StefanHoria/Industrial-Robot-Design/CATIA/imagini/Bac_V1_sus.png

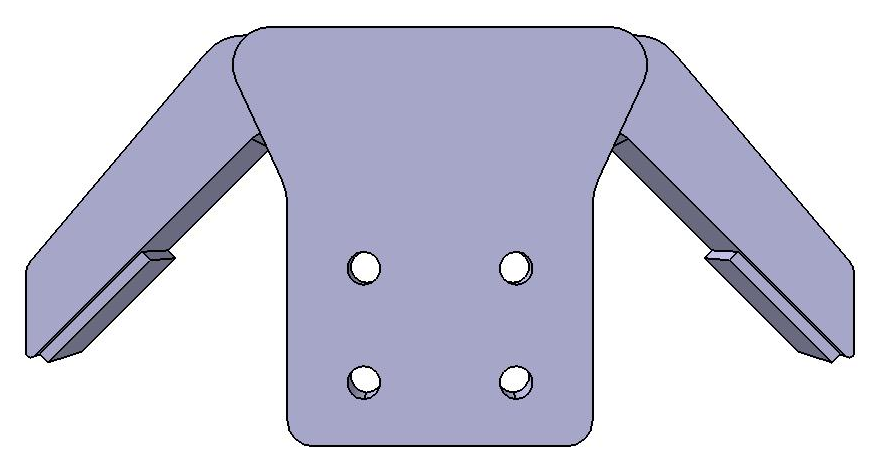
CATIA/imagini/Bac_V1_sus.png
