StefanHoria/Industrial-Robot-Design/CATIA/imagini/Bac_V_sus.png

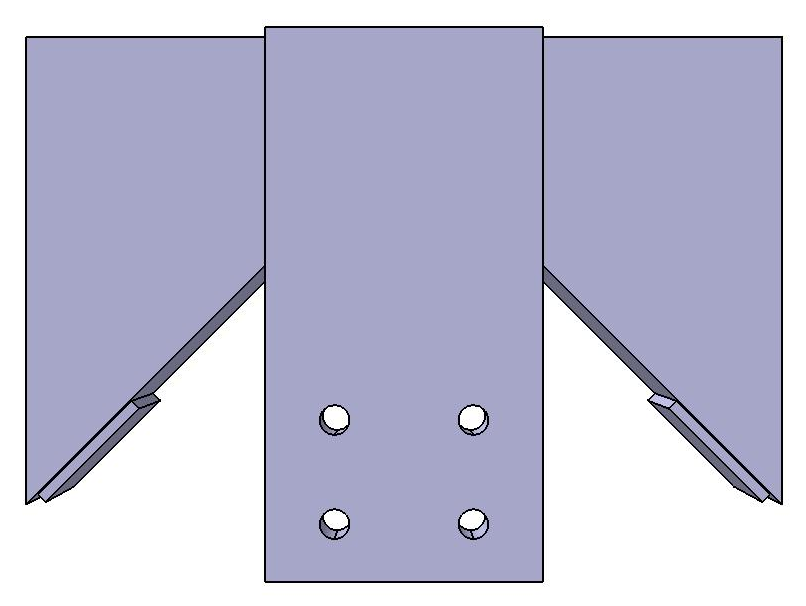
CATIA/imagini/Bac_V_sus.png
