StefanHoria/Industrial-Robot-Design/CATIA/imagini/Efector_E1_fata.png

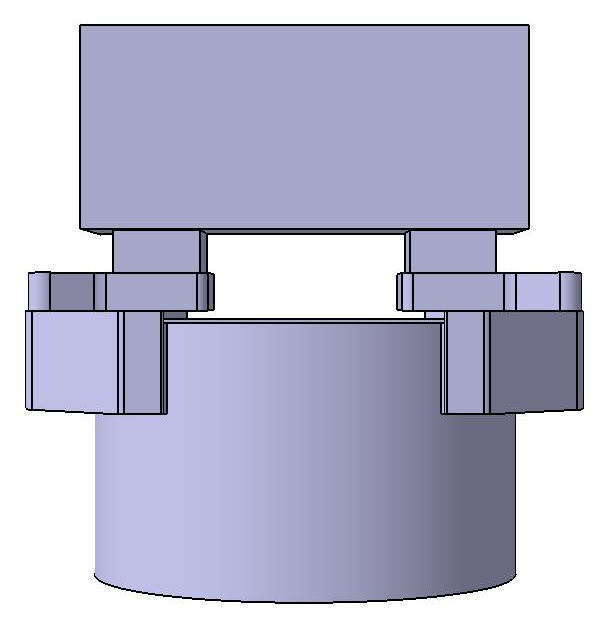
CATIA/imagini/Efector_E1_fata.png
