StefanHoria/Industrial-Robot-Design/CATIA/imagini/Efector_E_fata.png

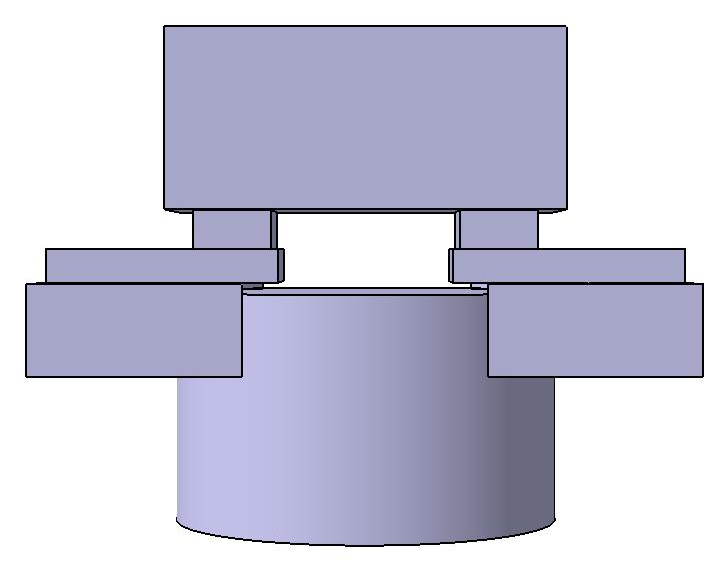
CATIA/imagini/Efector_E_fata.png
