StefanHoria/Industrial-Robot-Design/CATIA/imagini/R1_Corp_iso.png

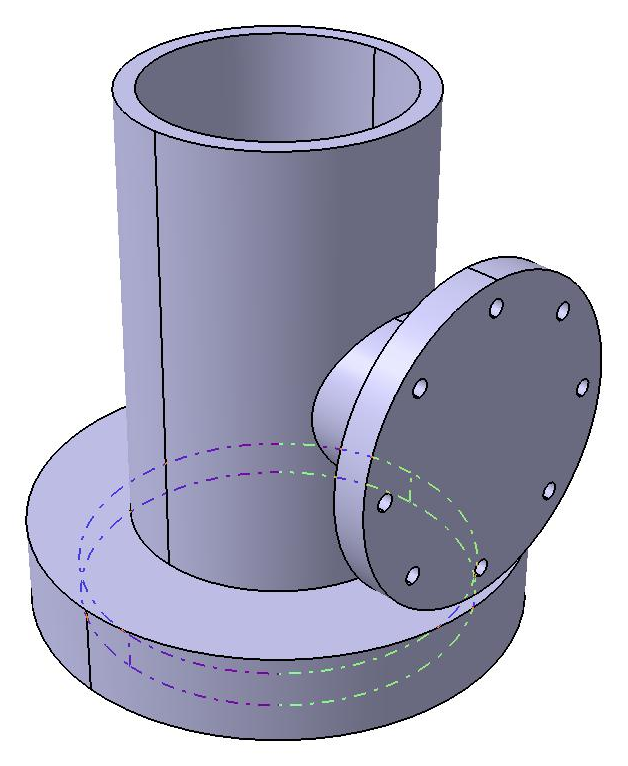
CATIA/imagini/R1_Corp_iso.png
