StefanHoria/Industrial-Robot-Design/MATLAB/ver1/imagini/model_simscape.png

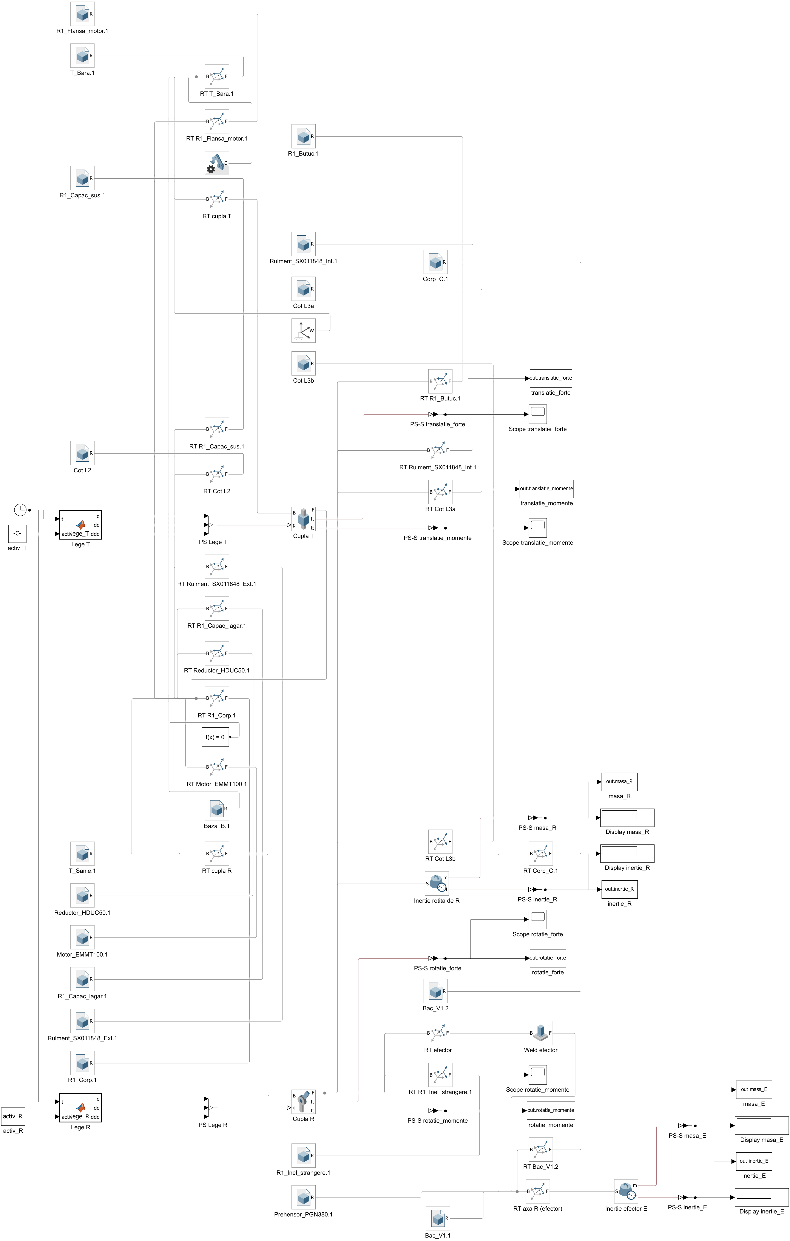
MATLAB/ver1/imagini/model_simscape.png
