StefanHoria/Industrial-Robot-Design/schema_functionla.jpg

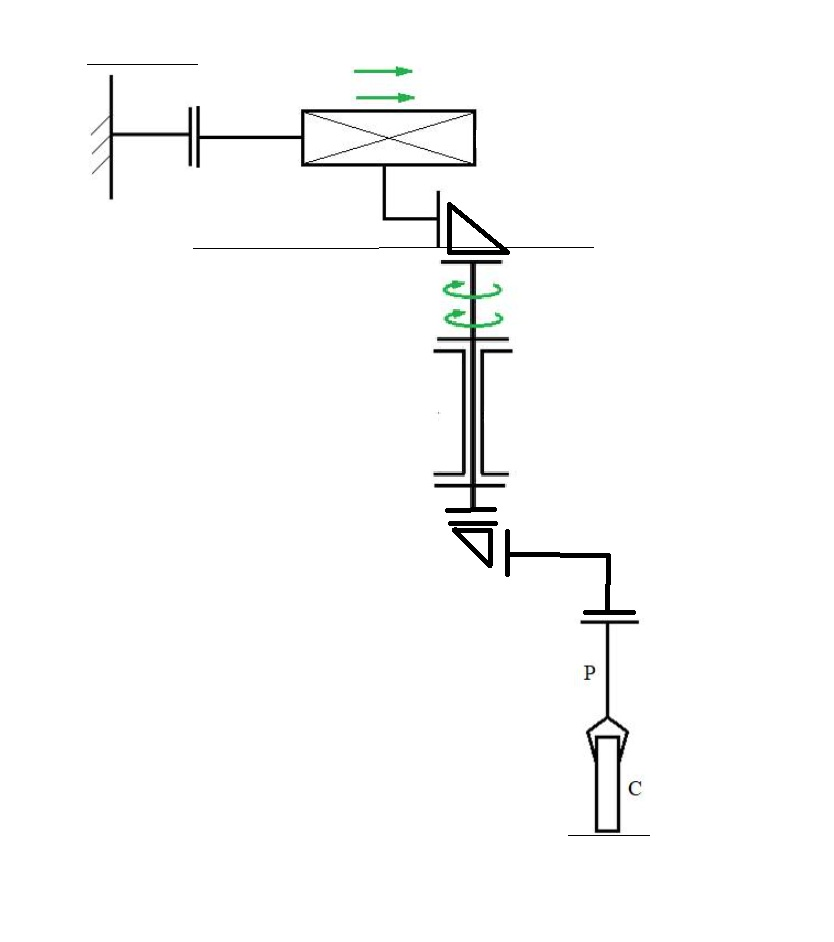
schema_functionla.jpg
