StefanHoria/Industrial-Robot-Design/CATIA/STEP/R1_Corp.stp

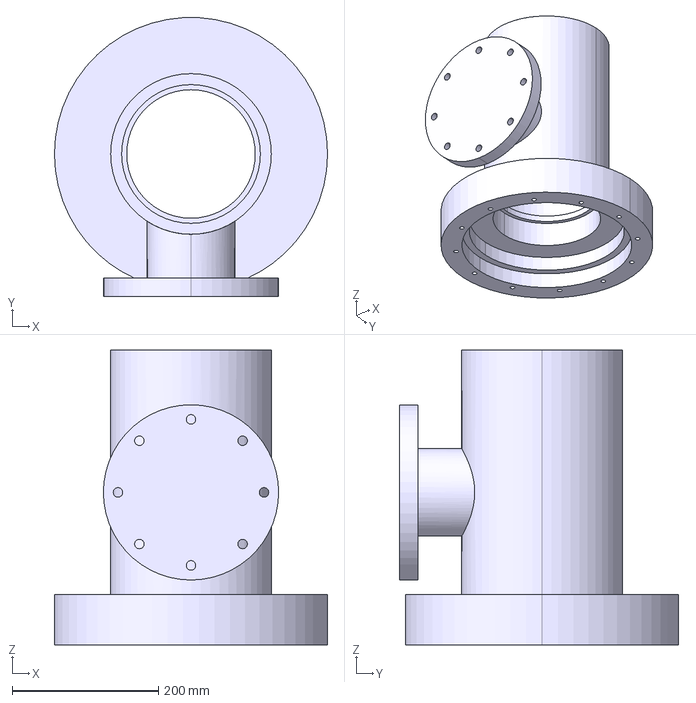
[picture p45: CAD file, 2026-11-06]
CATIA/STEP/R1_Corp.stp
374.0 x 381.7 x 404.0 mm
