StefanHoria/Industrial-Robot-Design/CATIA/STEP/R1_Flansa_motor.stp

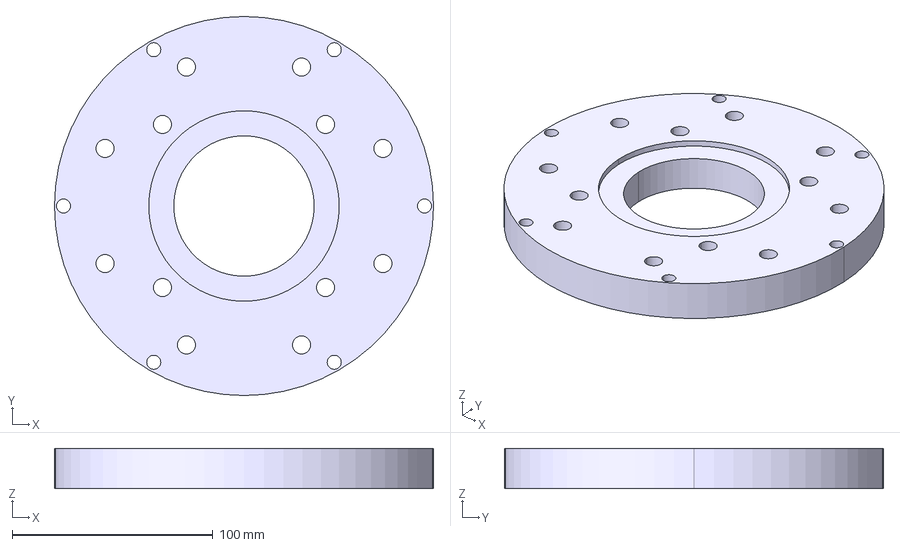
[picture p46: CAD file, 2026-11-06]
CATIA/STEP/R1_Flansa_motor.stp
189.0 x 189.0 x 20.0 mm
