StefanHoria/Industrial-Robot-Design/CATIA/STEP/Rulment_SX011848_Ext.stp

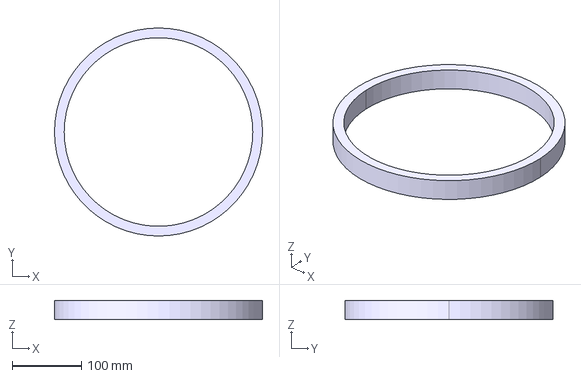
[picture p47: CAD file, 2026-11-06]
CATIA/STEP/Rulment_SX011848_Ext.stp
300.0 x 300.0 x 28.0 mm
