StefanHoria/Industrial-Robot-Design/CATIA/STEP/Modul_R1.stp

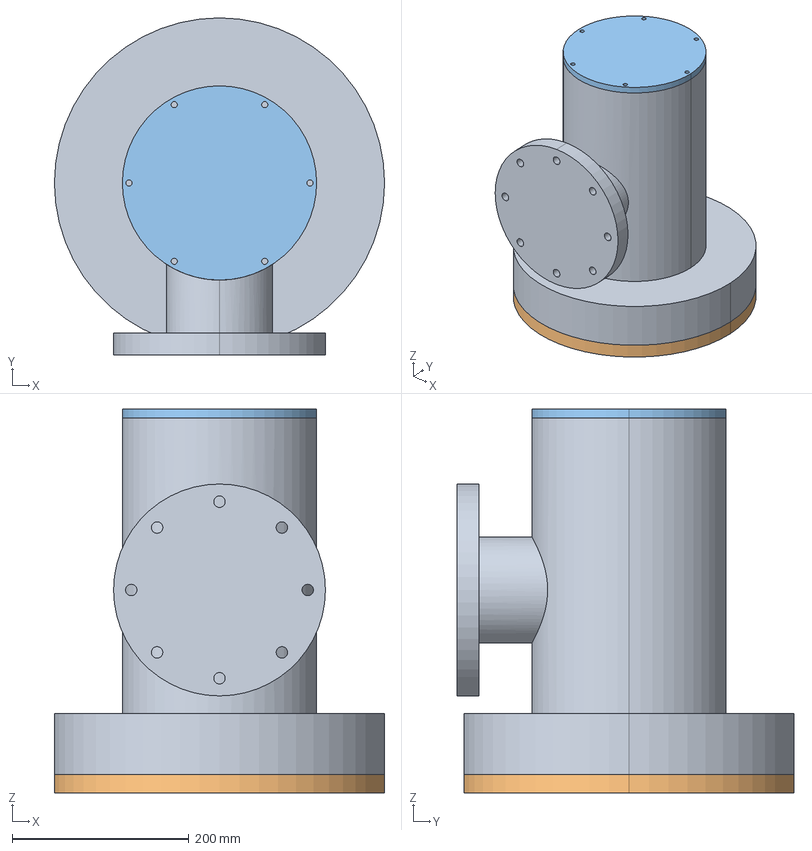
[picture p48: CAD file, 2026-11-06]
CATIA/STEP/Modul_R1.stp
374.0 x 382.0 x 435.0 mm
R1_Corp
R1_Capac_lagar
Rulment_SX011848_Ext
Rulment_SX011848_Int
R1_Butuc
R1_Inel_strangere
Reductor_HDUC50
R1_Flansa_motor
Motor_EMMT100
R1_Capac_sus
