StefanHoria/Industrial-Robot-Design/CATIA/STEP/R1_Butuc.stp

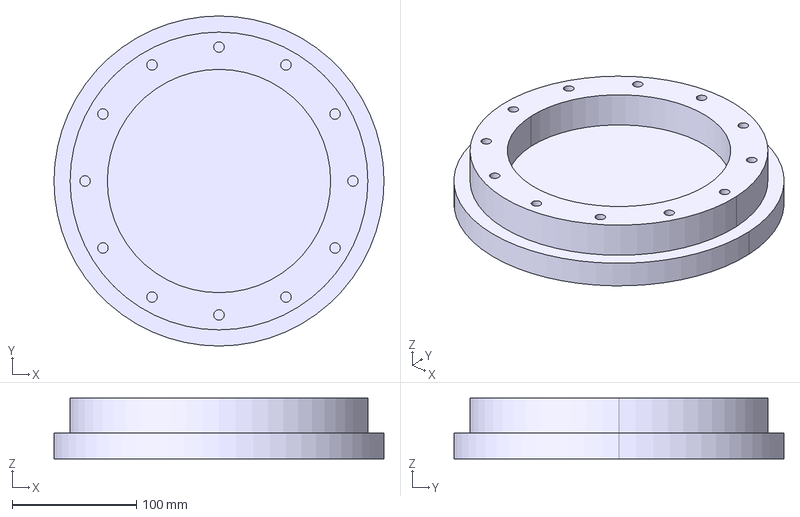
[picture p49: CAD file, 2026-11-06]
CATIA/STEP/R1_Butuc.stp
266.0 x 266.0 x 49.0 mm
