StefanHoria/Industrial-Robot-Design/CATIA/STEP/R1_Inel_strangere.stp

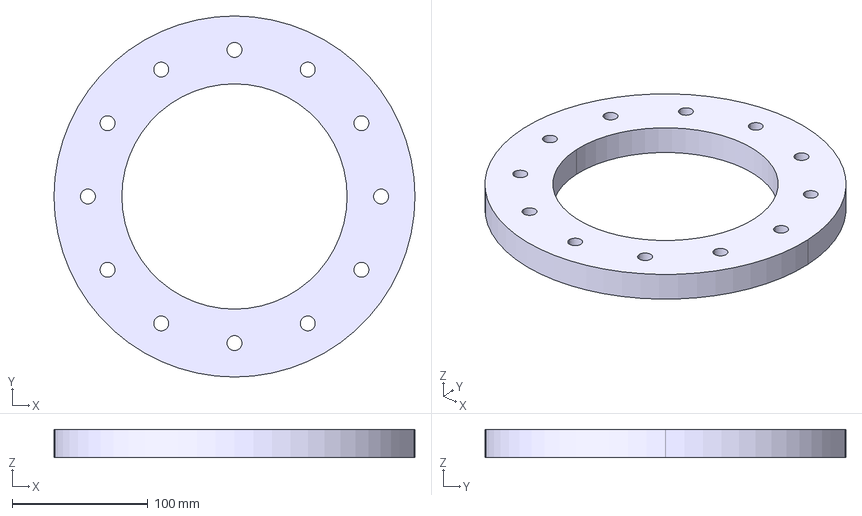
[picture p50: CAD file, 2026-11-06]
CATIA/STEP/R1_Inel_strangere.stp
266.0 x 266.0 x 21.0 mm
