StefanHoria/Industrial-Robot-Design/CATIA/STEP/Bac_V1.stp

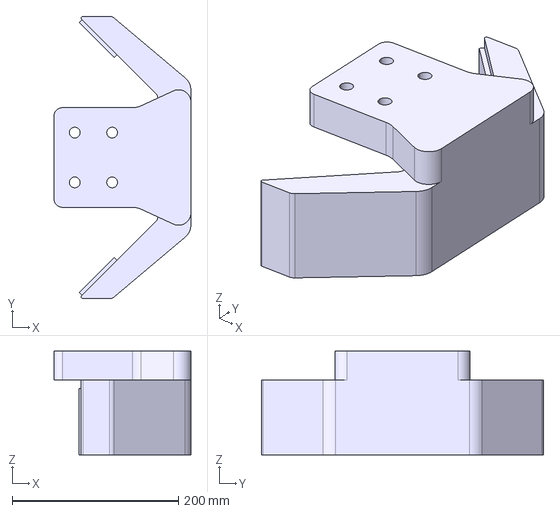
[picture p51: CAD file, 2026-11-06]
CATIA/STEP/Bac_V1.stp
165.0 x 340.0 x 125.0 mm
