StefanHoria/Industrial-Robot-Design/CATIA/STEP/Efector_E1.stp

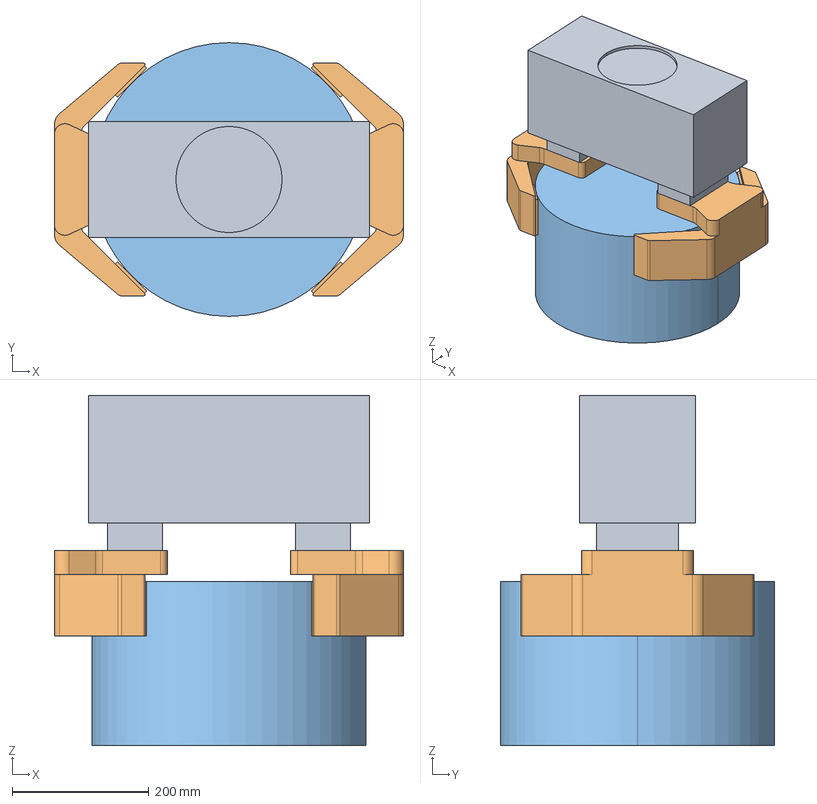
[picture p52: CAD file, 2026-11-06]
CATIA/STEP/Efector_E1.stp
510.0 x 400.0 x 511.5 mm
Prehensor_PGN380
Bac_V1 x 2
Corp_C
