StefanHoria/Industrial-Robot-Design/CATIA/STEP/Reductor_HDUC50.stp

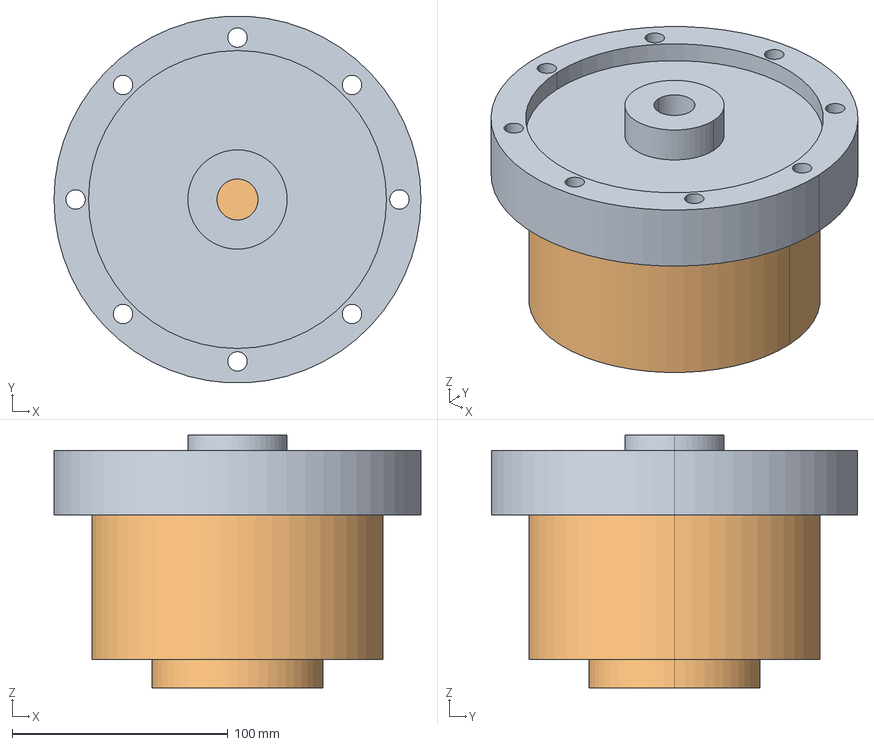
[picture p53: CAD file, 2026-11-06]
CATIA/STEP/Reductor_HDUC50.stp
170.0 x 169.8 x 117.0 mm
