StefanHoria/Industrial-Robot-Design/CATIA/STEP/Rulment_SX011848_Int.stp

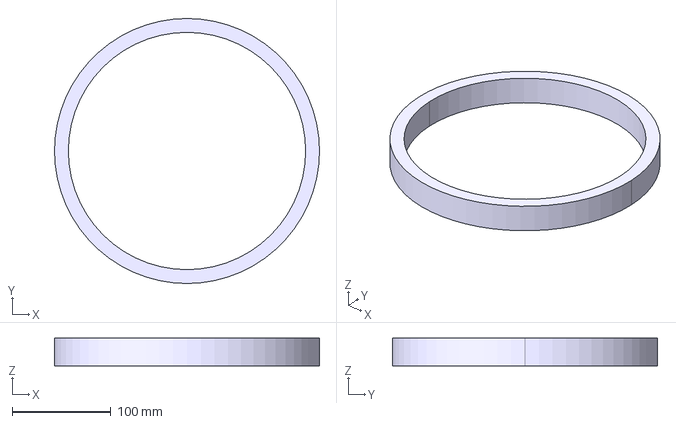
[picture p54: CAD file, 2026-11-06]
CATIA/STEP/Rulment_SX011848_Int.stp
268.0 x 268.0 x 28.0 mm
