StefanHoria/Industrial-Robot-Design/CATIA/STEP/Motor_EMMT100.stp

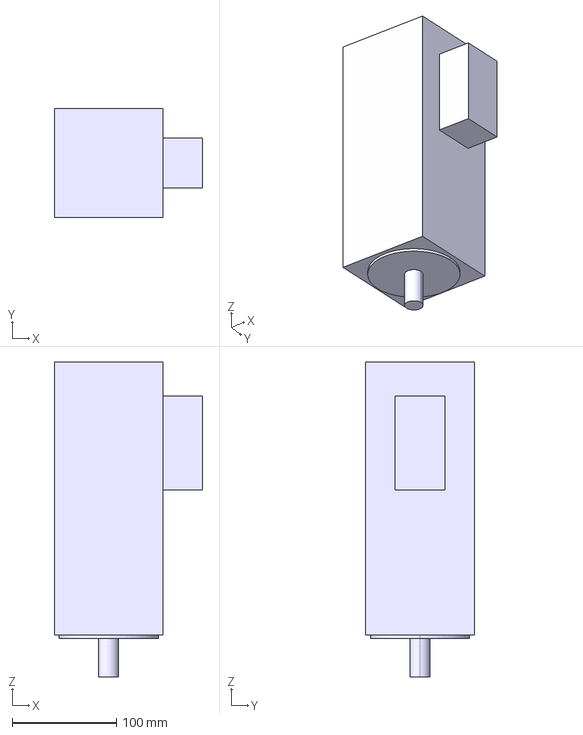
[picture p55: CAD file, 2026-11-06]
CATIA/STEP/Motor_EMMT100.stp
142.0 x 104.0 x 301.7 mm
