StefanHoria/Industrial-Robot-Design/CATIA/STEP/R1_Capac_sus.stp

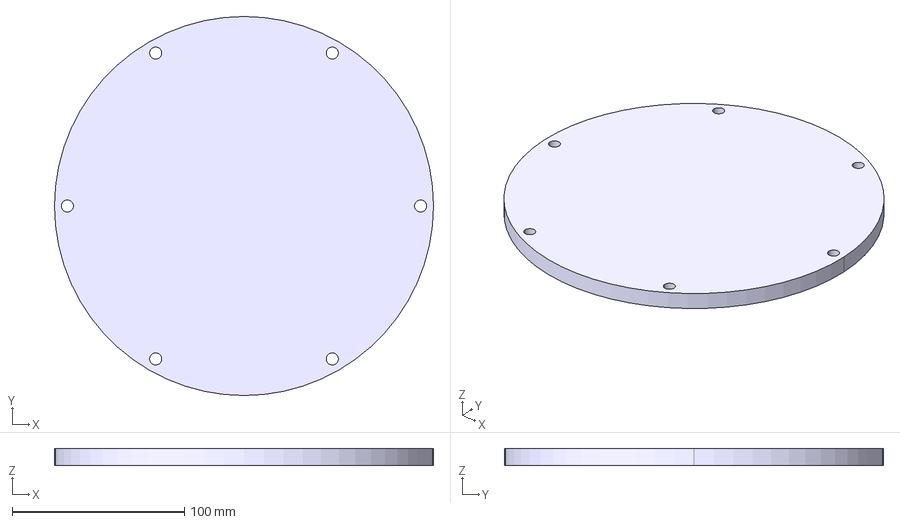
[picture p56: CAD file, 2026-11-06]
CATIA/STEP/R1_Capac_sus.stp
220.0 x 220.0 x 10.0 mm
