StefanHoria/Industrial-Robot-Design/CATIA/STEP/R1_Capac_lagar.stp

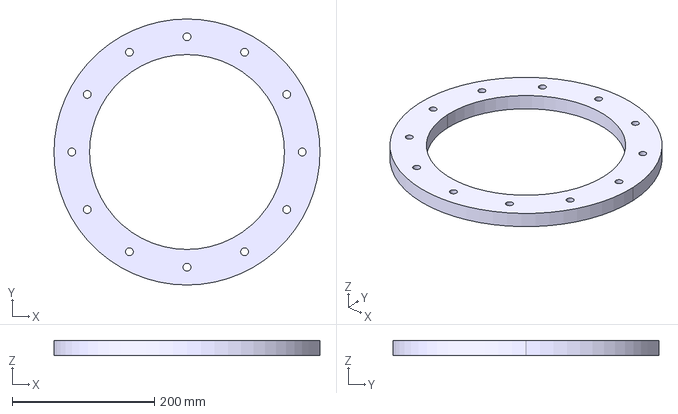
[picture p57: CAD file, 2026-11-06]
CATIA/STEP/R1_Capac_lagar.stp
374.0 x 374.0 x 21.0 mm
