StefanHoria/Industrial-Robot-Design/CATIA/STEP/Robot_v1.stp

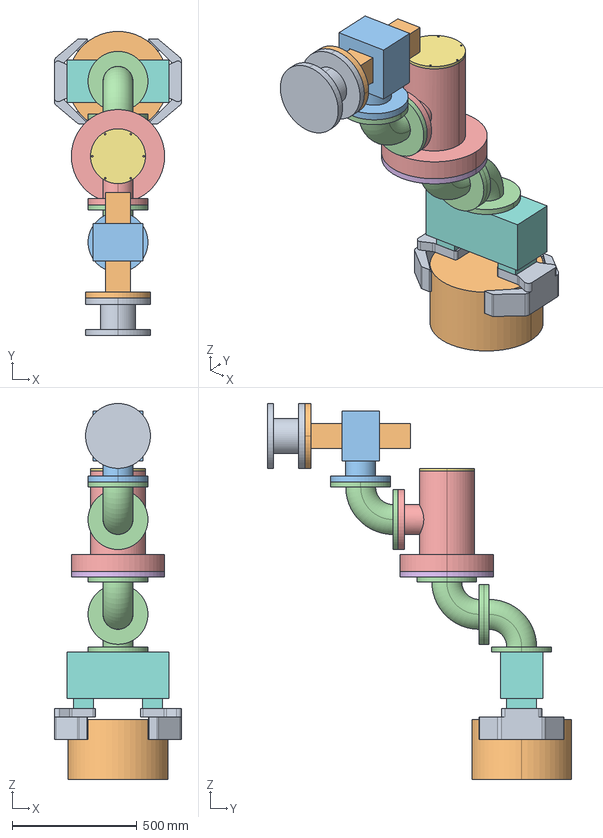
[picture p58: CAD file, 2026-11-06]
CATIA/STEP/Robot_v1.stp
510.0 x 1218.8 x 1506.5 mm
Baza_B
T_Bara
T_Sanie
Cot_90 x 3
R1_Corp
R1_Capac_lagar
Rulment_SX011848_Ext
Rulment_SX011848_Int
R1_Butuc
R1_Inel_strangere
Reductor_HDUC50
R1_Flansa_motor
Motor_EMMT100
R1_Capac_sus
Prehensor_PGN380
Bac_V1 x 2
Corp_C
