StefanHoria/Industrial-Robot-Design/CATIA/STEP/T_Sanie.stp

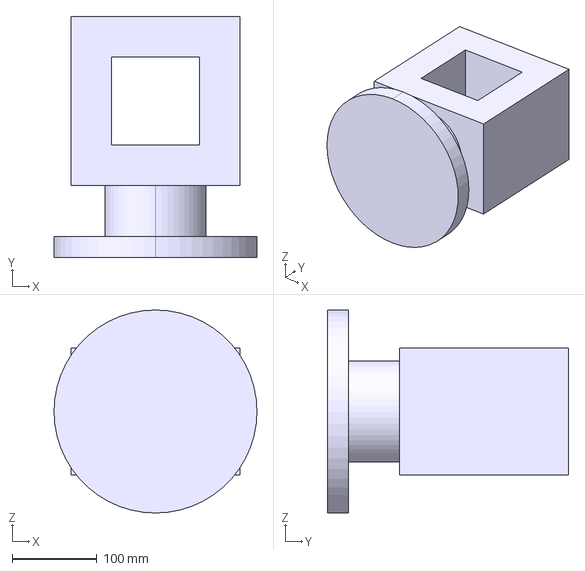
[picture p59: CAD file, 2026-11-03]
CATIA/STEP/T_Sanie.stp
240.0 x 285.0 x 240.0 mm
