StefanHoria/Industrial-Robot-Design/CATIA/STEP/Bac_V.stp

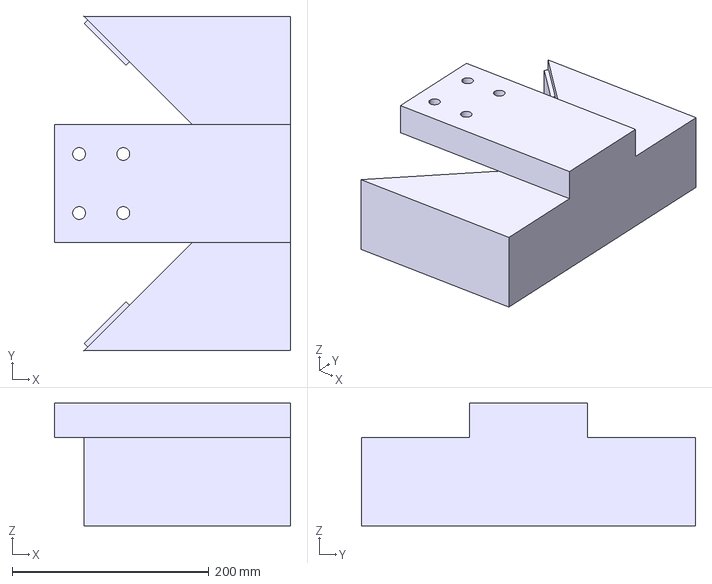
[picture p60: CAD file, 2026-11-03]
CATIA/STEP/Bac_V.stp
239.9 x 340.0 x 125.0 mm
