StefanHoria/Industrial-Robot-Design/CATIA/STEP/Modul_R.stp

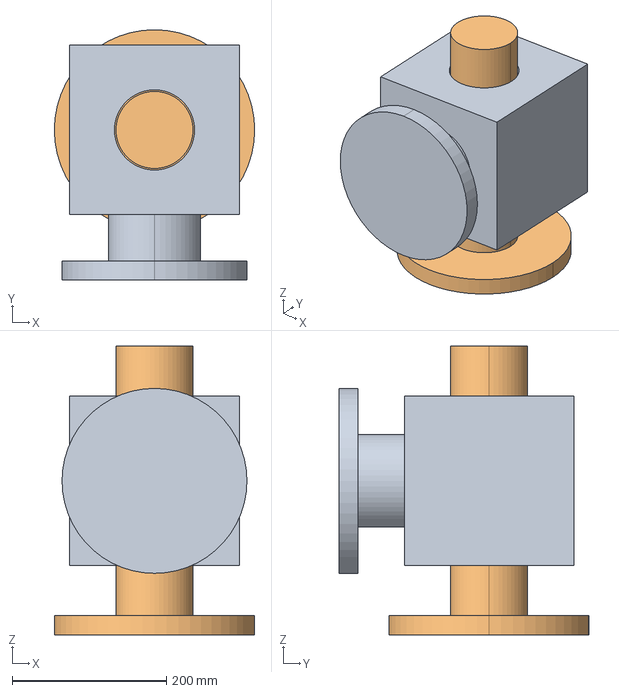
[picture p61: CAD file, 2026-11-03]
CATIA/STEP/Modul_R.stp
260.0 x 325.0 x 375.0 mm
R_Carcasa
R_Arbore
