StefanHoria/Industrial-Robot-Design/CATIA/STEP/T_Bara.stp

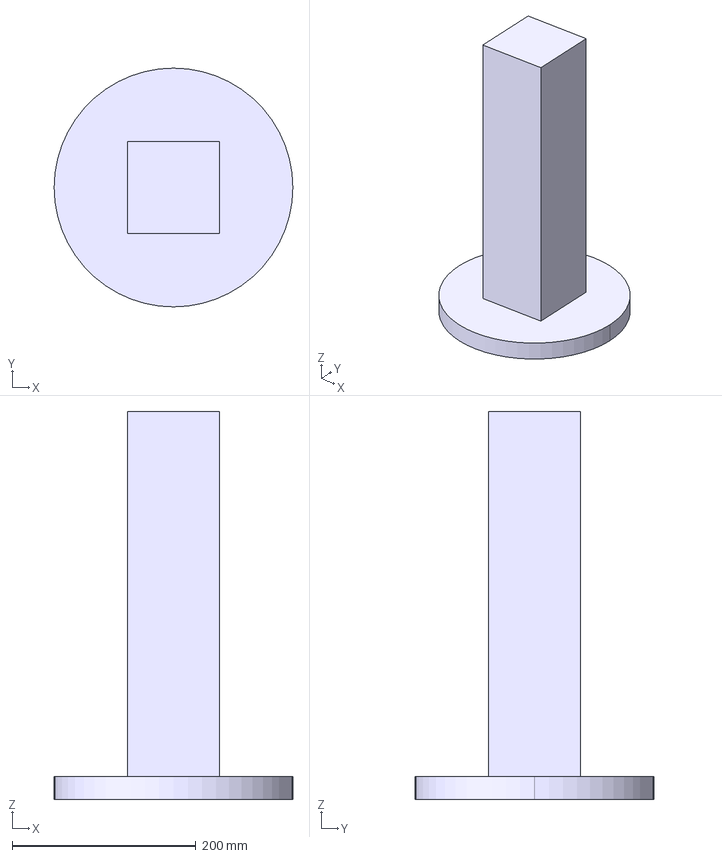
[picture p62: CAD file, 2026-11-03]
CATIA/STEP/T_Bara.stp
260.0 x 260.0 x 422.5 mm
