StefanHoria/Industrial-Robot-Design/CATIA/STEP/R_Arbore.stp

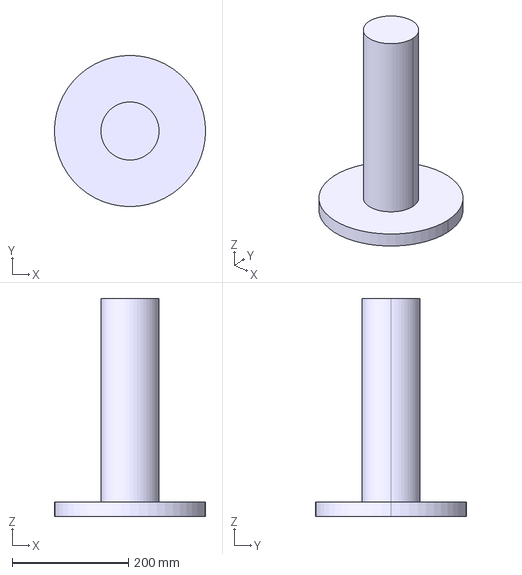
[picture p63: CAD file, 2026-11-03]
CATIA/STEP/R_Arbore.stp
260.0 x 260.0 x 375.0 mm
