StefanHoria/Industrial-Robot-Design/CATIA/STEP/Efector_E.stp

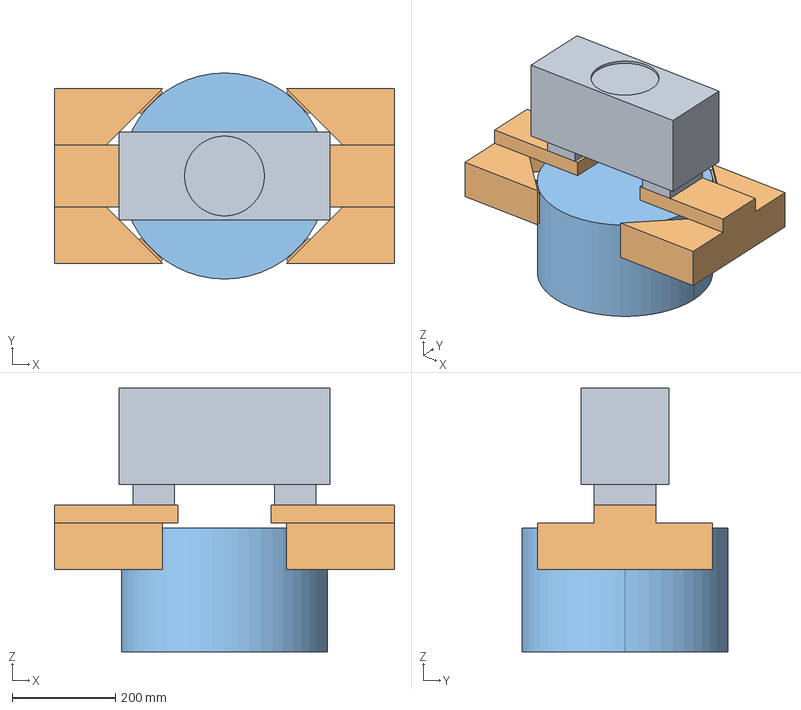
[picture p64: CAD file, 2026-11-03]
CATIA/STEP/Efector_E.stp
659.8 x 400.0 x 511.5 mm
Prehensor_PGN380
Bac_V x 2
Corp_C
