StefanHoria/Industrial-Robot-Design/CATIA/STEP/Baza_B.stp

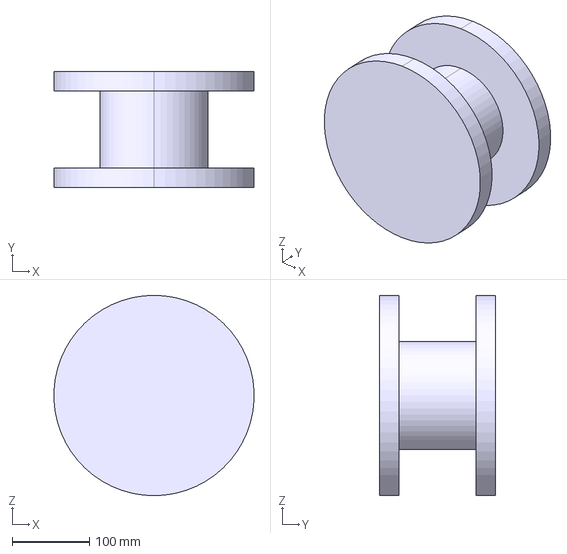
[picture p65: CAD file, 2026-11-03]
CATIA/STEP/Baza_B.stp
259.6 x 150.0 x 260.0 mm
