StefanHoria/Industrial-Robot-Design/CATIA/STEP/Prehensor_PGN380.stp

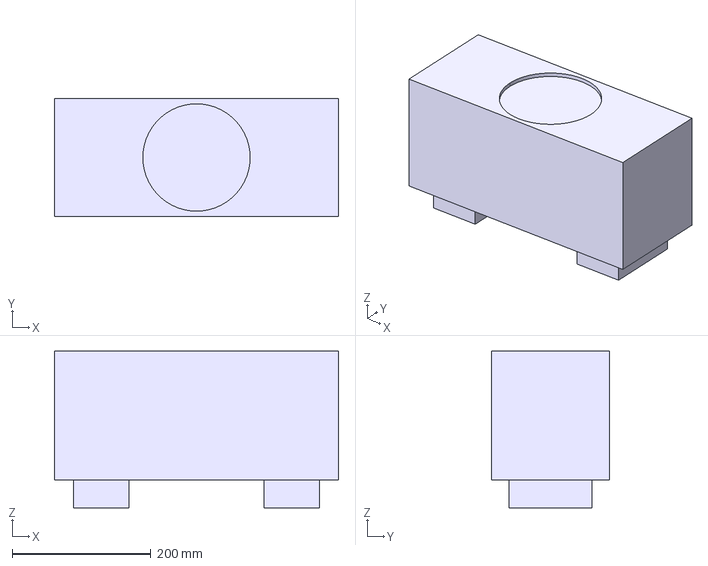
[picture p66: CAD file, 2026-11-03]
CATIA/STEP/Prehensor_PGN380.stp
410.0 x 170.0 x 226.5 mm
