StefanHoria/Industrial-Robot-Design/CATIA/STEP/Modul_T.stp

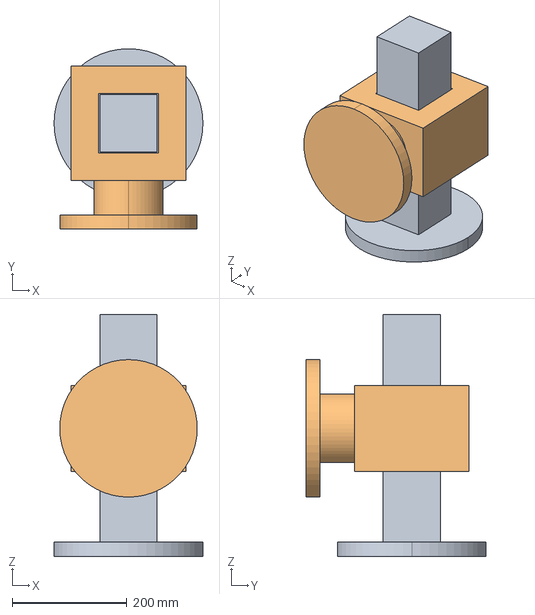
[picture p67: CAD file, 2026-11-03]
CATIA/STEP/Modul_T.stp
260.0 x 315.0 x 422.5 mm
T_Bara
T_Sanie
