StefanHoria/Industrial-Robot-Design/CATIA/STEP/Cot_90.stp

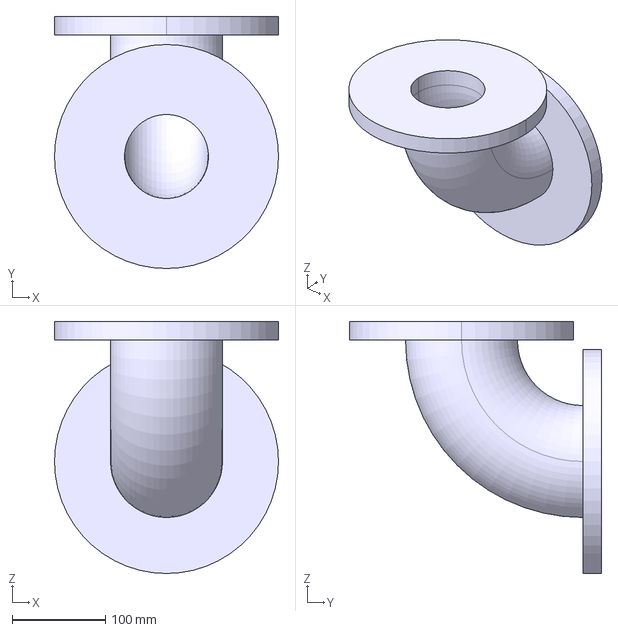
[picture p68: CAD file, 2026-11-03]
CATIA/STEP/Cot_90.stp
240.0 x 270.0 x 270.0 mm
