StefanHoria/Industrial-Robot-Design/CATIA/STEP/Corp_C.stp

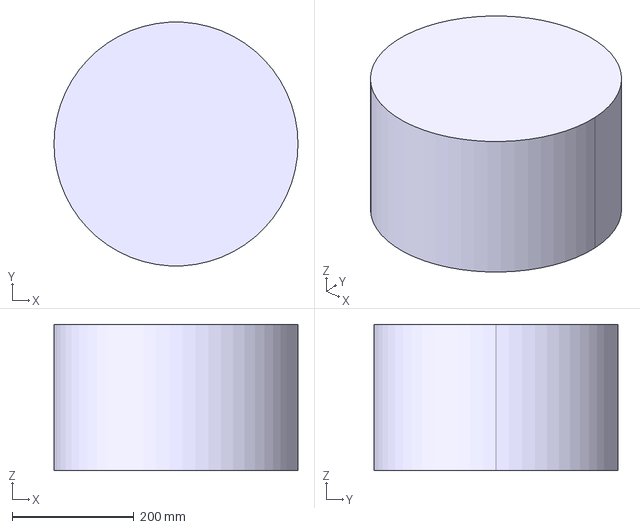
[picture p69: CAD file, 2026-11-03]
CATIA/STEP/Corp_C.stp
400.0 x 399.4 x 240.0 mm
