StefanHoria/Industrial-Robot-Design/CATIA/STEP/R_Carcasa.stp

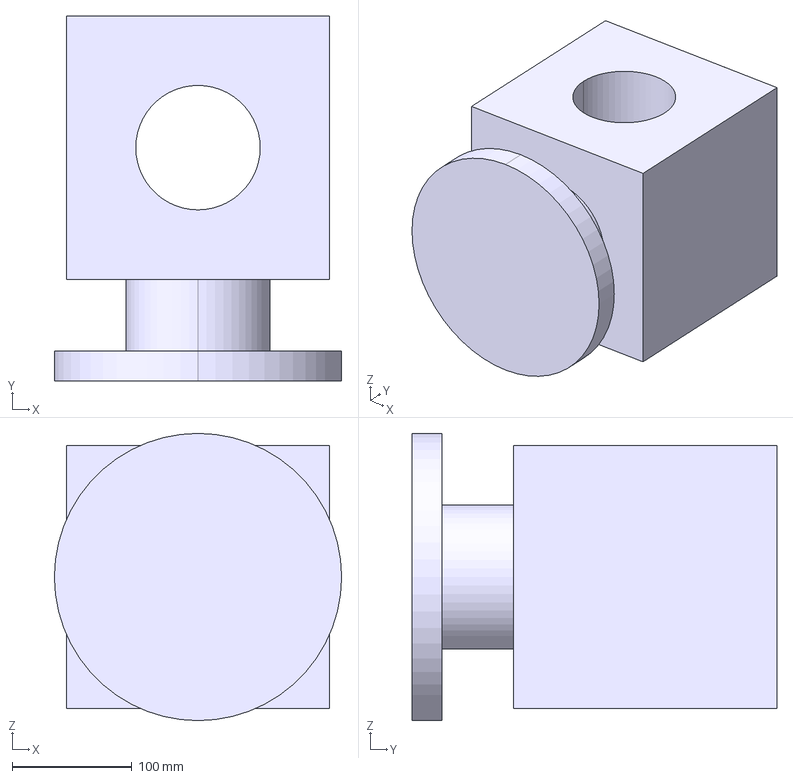
[picture p70: CAD file, 2026-11-03]
CATIA/STEP/R_Carcasa.stp
240.0 x 305.0 x 240.0 mm
