StefanHoria/Industrial-Robot-Design/(list of files, cad)

Other CAD files:
CATIA/Bac_V.CATPart
CATIA/Bac_V1.CATPart
CATIA/Baza_B.CATPart
CATIA/Corp_C.CATPart
CATIA/Cot_90.CATPart
CATIA/Efector_E.CATProduct
CATIA/Efector_E1.CATProduct
CATIA/Modul_R.CATProduct
CATIA/Modul_R1.CATProduct
CATIA/Modul_T.CATProduct
CATIA/Motor_EMMT100.CATPart
CATIA/Prehensor_PGN380.CATPart
CATIA/R1_Butuc.CATPart
CATIA/R1_Capac_lagar.CATPart
CATIA/R1_Capac_sus.CATPart
CATIA/R1_Corp.CATPart
CATIA/R1_Flansa_motor.CATPart
CATIA/R1_Inel_strangere.CATPart
CATIA/R_Arbore.CATPart
CATIA/R_Carcasa.CATPart
CATIA/Reductor_HDUC50.CATPart
CATIA/Robot_v0.CATProduct
CATIA/Robot_v1.CATProduct
CATIA/Rulment_SX011848_Ext.CATPart
CATIA/Rulment_SX011848_Int.CATPart
CATIA/STEP/Robot_v0.stp
CATIA/T_Bara.CATPart
CATIA/T_Sanie.CATPart
