StefanHoria/Industrial-Robot-Design/(commit log)

2026-11-03 Robot design project: stages I-II
    Technical report, CATIA V5 model (version 0) and Simscape Multibody
    dynamic model of a wall-mounted T-R industrial robot that handles a
    237 kg steel cylinder.
    [Bac_V.CATPart, Bac_V.stp, Baza_B.CATPart, Baza_B.stp, Corp_C.CATPart, Corp_C.stp, Cot_90.CATPart, Cot_90.stp]
2026-11-06 Stage III: rotation module design and robot ver. 1
    Technical report: chapter 5 (reducer, servomotor, bearing and bolted joint selection and checks).
    CATIA: rotation module parts, Modul_R1 and Robot_v1 assemblies, STEP exports and images.
    MATLAB: Simscape Multibody model ver. 1 and result figures.
    README: stage III status, ver. 1 results.
    [Modul_R1.CATProduct, Modul_R1.stp, Motor_EMMT100.CATPart, Motor_EMMT100.stp, R1_Butuc.CATPart, R1_Butuc.stp, R1_Capac_lagar.CATPart, R1_Capac_lagar.stp]
2026-11-06 Stage III: improved V-jaws and more clearance at the R module flange
    CATIA: Bac_V1 and Efector_E1; lateral stem axis of the R module raised to 230 mm (20 mm clearance); Robot_v1 updated, STEP exports and images.
    MATLAB: ver. 1 model and figures re-run with the new geometry.
    Technical report: section 3.1.4 and chapter 5 updated with the new results.
    README: ver. 1 results.
    [Bac_V1.CATPart, Bac_V1.stp, Efector_E1.CATProduct, Efector_E1.stp, Modul_R1.CATProduct, Modul_R1.stp, Motor_EMMT100.CATPart, Motor_EMMT100.stp]
